bigman73/rider-kontrol/CREDITS.md

# Credits

Credits to other projects and assets

# Inspirations

## BarButtons

The [BarButtons](https://jaxeadv.com/barbuttons/) project has greatly inspired this project. The enclosure design was used as for the prototype, but there are plans for another much slimmer design.

Note: The firmware of BarButtons was not used, a very different approach was taken, and Rider Kontrol firmware is written from scratch.

# Third-Party Libraries and Tools

## Libraries

- [ESP32 BLE Keyboard](https://github.com/T-vK/ESP32-BLE-Keyboard) - Bluetooth Low Energy Keyboard control SDK

## Assets

[Blade Runner Movie](https://www.dafont.com/blade-runner-movie-font.font) font used for logo
