bigman73/rider-kontrol/assets/ESP32-C3-Super-Mini-logical-pinout.png

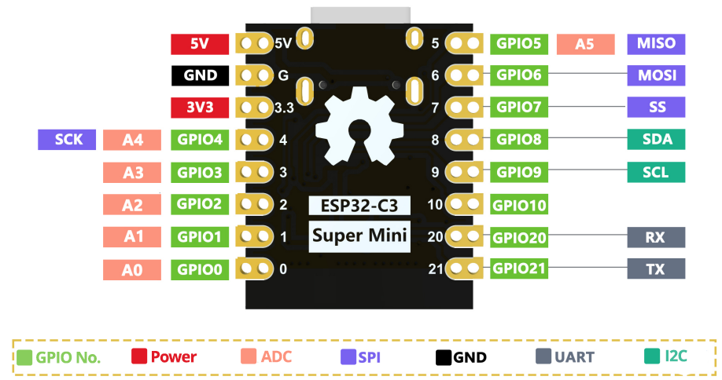
assets/ESP32-C3-Super-Mini-logical-pinout.png
