bigman73/rider-kontrol/assets/ESP32-C3-Super-Mini-real-pinout.png

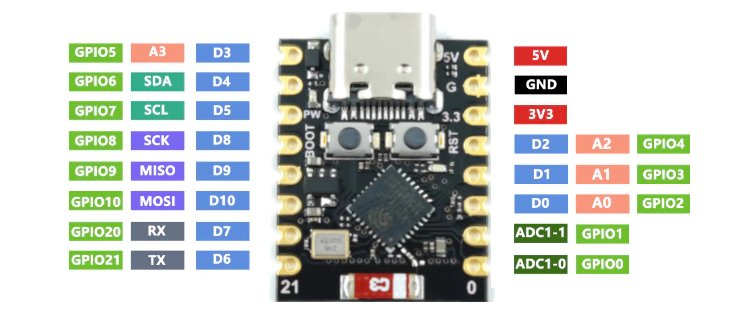
assets/ESP32-C3-Super-Mini-real-pinout.png
