bigman73/rider-kontrol/firmware/ledLogic.h

#pragma once

/**
  Controls the onboard LED
 */
 void controlOnboardLED();

 /**
  Blink heartbeat of external LED
 */
void heartbeatExternalLED();

/*
  Controls the external LED
*/
void controlExternalLED();

/**
 * Control the LEDs.
 */
void controlLEDs();
