bigman73/rider-kontrol/(commit log)

2026-02-17 feat: add c3 pin out images
2026-02-26 feat: use on board led rgb colors
2026-02-26 test: firmware for onboard color led
2026-03-05 fix: diag mode default of 2 minutes
    [constants.h]
2026-03-07 test: buttons
2026-03-07 docs: fixed button layout
2026-03-07 docs: improved README, added arduino library instructions
2026-03-07 feat: add debounced button logic refactor: led control logic
2026-03-08 feat: setup buttons dynamically
2026-03-08 feat: add button definition class, button kind and actions
2026-03-08 fix: next track instead of mute
    [constants.h, firmware.ino]
2026-03-10 fix: continous button logic
    [firmware.ino]
2026-03-15 feat: external led heartbeat
2026-03-15 feat: heartbeat cooldown after button press
2026-03-15 refactor: clean up button handling
2026-03-15 feat: all buttons and actions are functional, including media
2026-03-15 feat: external led with short long buttons
    [constants.h, firmware.ino, vars.cpp]
2026-03-21 docs: add button layout, update button mapping and setup sections
2026-03-21 docs: c3 mini board
2026-03-28 docs: add Arduino IDE Configuration section
2026-03-29 chore: arduino CLI and scripts
2026-03-29 feat: print active partition info on boot
2026-03-29 feat: added initial wifi OTA capability feat: reboot command
    [constants.h, firmware.ino, wifiOTA.cpp, wifiOTA.h]
2026-04-05 feat: toggle ota with B4 button (very long press)
2026-04-19 docs: initial assembly readme
2026-04-23 docs: image of mounting on motorcycle
